sruetzler/HB-SR-Devices-AddOn/devices/HB-SR-HY/docs/HM-CC-TC_HM-CC-VD_Protokoll.md

# HomeMatic HM-CC-TC ↔ HM-CC-VD – Protokolldokumentation

Stand: 2026-11-01

## 1. Scope

Dieses Dokument beschreibt die direkte Funkkommunikation zwischen:

- **HM-CC-TC** – HomeMatic Funk-Wandthermostat
- **HM-CC-VD** – HomeMatic Funk-Stellantrieb

Betrachtet wird die bereits **dekodierte BidCoS-Telegrammebene**:

```text
COUNTER CTRL TYPE SRC DST PAYLOAD
```

Nicht Bestandteil der eigentlichen Protokollbeschreibung sind:

- physikalische 868-MHz-Funkebene
- Preamble / Sync / Whitening / CRC-Berechnung
- Anlernen / Peering
- Kommunikation mit einer CCU

Praktisch relevante **HY-/CC1101-Implementierungserkenntnisse** werden am Ende
bewusst separat dokumentiert. Sie sind keine Eigenschaften der BidCoS-
Protokollsemantik.

Die Dokumentation basiert auf:

1. eQ-3-Gerätehandbüchern,
2. öffentlich dokumentiertem BidCoS-Reverse-Engineering,
3. FHEM-Implementierung für HM-CC-TC/HM-CC-VD,
4. realen HMLAN/FHEM-Funkmitschnitten,
5. lokalen CCU-`multimac`-Mitschnitten, Oszilloskopmessungen an realen TC/VD-Paaren und gezielten HY-Emulationsversuchen.

Da das proprietäre BidCoS-Protokoll nicht vollständig offiziell veröffentlicht wurde, wird zwischen **belegt**, **sehr wahrscheinlich**, **rekonstruiert** und **offen** unterschieden.

---

# 2. Grundprinzip

Der HM-CC-TC ist der eigentliche Raumregler.

Er:

1. misst die Raumtemperatur,
2. kennt Solltemperatur und Zeitprogramm,
3. berechnet daraus eine gewünschte Ventilöffnung,
4. überträgt diese zyklisch an den HM-CC-VD.

Die Regelung benötigt im normalen Betrieb keine CCU.

eQ-3 beschreibt einen zyklischen Kommunikationsabstand von:

```text
120 ... 184 Sekunden
```

Der HM-CC-VD bestätigt den empfangenen Stellbefehl und meldet dabei seinen aktuellen Zustand zurück.

---

# 3. Allgemeiner dekodierter BidCoS-Frame

Auf der hier betrachteten Ebene besteht ein Telegramm aus:

```text
LEN CNT CTRL TYPE SRC SRC SRC DST DST DST PAYLOAD...
```

Dabei:

| Feld | Größe | Bedeutung |
|---|---:|---|
| LEN | 1 Byte | Länge ab `CNT` bis Ende Payload |
| CNT | 1 Byte | Message Counter / Sequence Number |
| CTRL | 1 Byte | Steuerflags |
| TYPE | 1 Byte | Nachrichtentyp |
| SRC | 3 Byte | 24-Bit-Senderadresse |
| DST | 3 Byte | 24-Bit-Empfängeradresse |
| PAYLOAD | variabel | typabhängige Nutzdaten |

Die 24-Bit-Adressen sind Geräteadressen.

---

# 4. Message Counter

Der Message Counter ist 8 Bit breit:

```text
00 ... FF
```

und läuft modulo 256:

```text
FC
FD
FE
FF
00
01
...
```

Er wird bei einer neuen Kommunikationssequenz erhöht.

Eine Anfrage und die zugehörige Antwort verwenden **denselben Counter**.

Beispiel:

```text
TC → VD
CNT=4A A2 58 ...

VD → TC
CNT=4A 82 02 ...
```

Der nächste reguläre Zyklus verwendet anschließend beispielsweise:

```text
CNT=4B
```

---

# 5. Control-Byte

Für die hier relevanten Telegramme sind besonders folgende Bits wichtig:

| Bit | Maske | Bedeutung |
|---:|---:|---|
| 0 | `0x01` | WakeUp |
| 1 | `0x02` | WakeMeUp |
| 2 | `0x04` | Broadcast |
| 4 | `0x10` | Burst |
| 5 | `0x20` | ACK Request |
| 6 | `0x40` | Repeated |
| 7 | `0x80` | Repeat Enable |

## 5.1 `CTRL = 0xA2`

Normale TC→VD-Stelltelegramme verwenden typischerweise:

```text
A2 = 1010 0010
```

gesetzt sind:

```text
0x80 Repeat Enable
0x20 ACK Request
0x02 WakeMeUp
```

Nicht gesetzt ist insbesondere:

```text
0x10 Burst
```

Das normale Stelltelegramm wird also **nicht als Burst** gesendet.

### Bedeutung von WakeMeUp

`WakeMeUp` bedeutet nicht:

> Wecke den Empfänger auf.

Sondern sinngemäß:

> Der Sender ist nach diesem Telegramm noch für kurze Zeit empfangsbereit.

Beim `A2 58` bezieht sich das daher auf den HM-CC-TC als Sender.

Der HM-CC-VD muss bereits aufgrund seines zyklischen Empfangstimings wach sein.

## 5.2 `CTRL = 0x82`

Reale HM-CC-VD-Antworten werden häufig beobachtet als:

```text
82 02
```

`0x82` enthält:

```text
Repeat Enable
WakeMeUp
```

FHEM kann bei einer virtuellen Aktorantwort auch `0x80 02` erzeugen. Für die originale VD-Kommunikation ist `0x82` der typische beobachtete Wert.

---

# 6. TC → VD: CLIMATE_EVENT `TYPE=0x58`

Das zentrale Stelltelegramm lautet:

```text
CNT A2 58 TC_ID VD_ID COMMAND TARGET
```

Mit Length-Byte:

```text
0B CNT A2 58 TC_ID VD_ID COMMAND TARGET
```

## 6.1 Felder

| Feld | Bedeutung |
|---|---|
| CNT | globaler Message Counter des TC |
| CTRL | normalerweise `A2` |
| TYPE | `58` = `CLIMATE_EVENT` |
| SRC | Adresse des HM-CC-TC |
| DST | Adresse des HM-CC-VD |
| Payload 0 | `ADJUSTING_COMMAND` |
| Payload 1 | `ADJUSTING_DATA` / Ventil-Sollwert |

FHEM kommentiert:

```text
adjust_command [0..4]
adj_data       [0..250]
```

## 6.2 Ventil-Sollwert

Der normale Ventil-Sollwert ist ungefähr:

```text
Sollposition [%] = TARGET_RAW / 2.56
```

bzw.

```text
TARGET_RAW ≈ Sollposition [%] × 2.56
```

Beispiele:

| Sollöffnung | Raw ungefähr |
|---:|---:|
| 0 % | `00` |
| 25 % | `40` |
| 50 % | `80` |
| 75 % | `C0` |

FHEM dekodiert den Wert mit:

```text
int(raw / 2.56 + 0.5)
```

Die Sonderfälle Voll-Auf/Voll-Zu können zusätzlich über `ADJUSTING_COMMAND` repräsentiert werden und sollten deshalb nicht ausschließlich aus dem Raw-Wert abgeleitet werden.

---

# 7. `ADJUSTING_COMMAND`

Der Wertebereich ist:

```text
00 ... 04
```

Die vollständige Enum-Bedeutung ist von eQ-3 öffentlich nicht sauber dokumentiert.

Der aktuelle Rekonstruktionsstand ist:

| Wert | vermutete Bedeutung | Sicherheit |
|---:|---|---|
| `00` | normaler zyklischer Stellwert / Refresh | sehr hoch |
| `01` | vermutlich `VENT_OPEN` | offen / Hypothese |
| `02` | `VENT_CLOSED` / OFF | hoch |
| `03` | neuer/geänderter Stellwert | sehr hoch |
| `04` | Entkalkungs-/Ventilfahrt | mittel bis hoch |

## 7.1 `00` – normaler zyklischer Stellwert

Bei unverändertem Sollwert werden reale Telegramme der Form:

```text
A2 58 ... 00 XX
```

beobachtet.

FHEMs TC-Emulation verwendet `00` für die folgenden zyklischen Wiederholungen eines bereits gesetzten Ventilwerts.

Interpretation:

```text
COMMAND = 00
DATA    = aktueller Ventilsollwert
```

## 7.2 `03` – neuer Stellwert

FHEM setzt bei einer Änderung der Ventilposition zunächst:

```text
COMMAND = 03
```

und danach wieder:

```text
COMMAND = 00
```

Ein typischer Ablauf ist daher:

```text
03 <neuer Sollwert>
00 <gleicher Sollwert>
00 <gleicher Sollwert>
00 <gleicher Sollwert>
```

Reale Funkmitschnitte passen zu diesem Verhalten.

## 7.3 `02` – VENT_CLOSED / OFF

Bei `desired-temp = off` wurden reale Telegramme beobachtet wie:

```text
A2 58 ... 02 00
```

Der VD schließt daraufhin das Ventil.

Daher ist sehr wahrscheinlich:

```text
COMMAND = 02
DATA    = 00
```

für den expliziten Sonderzustand `VENT_CLOSED`.

Dies ist semantisch von einem normalen:

```text
00 00
```

zu unterscheiden, auch wenn das mechanische Ergebnis ebenfalls ein geschlossenes Ventil sein kann.

## 7.4 `01` – vermutlich VENT_OPEN

Es gibt einen naheliegenden Zusammenhang mit dem HomeMatic-Sonderzustand `VENT_OPEN`.

Die Zuordnung:

```text
01 = VENT_OPEN
```

ist jedoch noch nicht durch einen ausreichend eindeutigen realen Mitschnitt bestätigt.

**Status: offen.**

## 7.5 `04` – Entkalkungsfahrt

`04` wurde im Zusammenhang mit der regelmäßigen Ventil-/Entkalkungsfahrt beobachtet.

Noch offen sind:

- genaue Bedeutung von `ADJUSTING_DATA`,
- vollständige Telegrammsequenz,
- Verhalten während der Adaptions-/Entkalkungsfahrt.

---

# 8. VD → TC: RESPONSE_ACK_STATUS

Der HM-CC-VD antwortet auf das `0x58` unmittelbar mit einem Response-Telegramm.

Typischer Aufbau:

```text
CNT 82 02 VD_ID TC_ID 01 01 POSITION STATUS RSSI
```

Mit Length:

```text
0E CNT 82 02 VD_ID TC_ID 01 01 POSITION STATUS RSSI
```

Dabei:

```text
TYPE    = 02 = RESPONSE
SUBTYPE = 01 = RESPONSE_ACK_STATUS
```

## 8.1 Felder

| Payload | Bedeutung |
|---:|---|
| Byte 0 | `01` = ACK_STATUS |
| Byte 1 | Kanal, normalerweise `01` |
| Byte 2 | aktuelle Ventilposition |
| Byte 3 | Status / Motor / Fehler |
| Byte 4 | RSSI-/Linkwert |

Der Antwort-Counter ist identisch mit dem Counter des auslösenden `0x58`.

## 8.2 Der TC verwendet `POSITION` für seine Ventilstellungsanzeige

Dies konnte mit einem realen HM-CC-TC und einer gezielt emulierten VD-Antwort direkt validiert werden.

Bei korrekt getroffenem ACK-Timing zeigte der TC exakt den aus `POSITION_RAW` dekodierten Wert:

```text
POSITION_RAW = 0x96 = 150  -> 75 %   -> TC zeigt 75 %
POSITION_RAW = 0x00        ->  0 %   -> TC zeigt  0 %
POSITION_RAW = 0x1E = 30   -> 15 %   -> TC zeigt 15 %
```

Damit ist nicht nur die Skalierung `/2` belegt, sondern auch die Semantik gegenüber dem TC:

```text
ACK_STATUS.POSITION = vom TC angezeigte aktuelle Ventilposition (VST)
```

Der Sollwert im vorherigen `0x58` und der vom VD gemeldete Istwert sind unabhängig. Während einer Motorfahrt kann der TC daher beispielsweise einen neuen Sollwert nahe 100 % senden und im ACK gleichzeitig noch eine deutlich kleinere aktuelle Ventilposition erhalten.

---

# 9. Aktuelle Ventilposition des VD

Die VD-Rückmeldung verwendet **eine andere Skalierung als der TC-Sollwert**.

Es gilt:

```text
Istposition [%] = POSITION_RAW / 2
```

bzw.

```text
POSITION_RAW = Istposition [%] × 2
```

Beispiele:

| Istposition | Raw |
|---:|---:|
| 0 % | `00` |
| 10 % | `14` |
| 25 % | `32` |
| 37 % | `4A` |
| 50 % | `64` |
| 100 % | `C8` |

Damit gilt ausdrücklich:

```text
TC → VD Sollwert: raw / 2.56

VD → TC Istwert: raw / 2
```

Diese unterschiedlichen Skalierungen sind durch FHEM und reale Mitschnitte gut belegt.

---

# 10. VD-Statusbyte

Das Statusbyte wird bisher wie folgt verstanden:

```text
Bit:  7 6 5 4 3 2 1 0
      │ │ └─┬─┘ └─┬─┘ │
      │ │   │     │   └─ unbekannt
      │ │   │     └──── Fehlercode
      │ │   └────────── Motorzustand
      │ └────────────── unbekannt
      └──────────────── Low Battery
```

## 10.1 Motorzustand – Bits 5..4

Maske:

```text
STATUS & 0x30
```

Bekannt:

| Wert | Zustand |
|---:|---|
| `0x00` | Motor steht |
| `0x10` | Motor öffnet |
| `0x20` | Motor schließt |
| `0x30` | Bedeutung noch offen |

FHEM verwendet:

```text
0x00 → stop
0x10 → opening
0x20 → closing
```

## 10.2 Fehler – Bits 3..1

Dekodierung:

```text
error = (STATUS >> 1) & 0x07
```

Bekannte Codes:

| Code | Bedeutung |
|---:|---|
| 0 | kein Fehler |
| 1 | Ventil blockiert / schwergängig |
| 2 | Antrieb locker / nicht korrekt montiert bzw. Stellproblem |
| 3 | Stellbereich zu klein |
| 4 | Batterie kritisch |

Die Anzeigen des originalen VD entsprechen den bekannten Fehlern F1...F4.

## 10.3 Batterie

Zusätzlich wird:

```text
STATUS & 0x80
```

als `Low Battery` ausgewertet.

Damit gibt es mindestens eine Unterscheidung zwischen:

- Batterie niedrig (`Bit 7`)
- Batterie kritisch (`Errorcode 4`)

## 10.4 Noch unbekannte Statusbits

Offen:

```text
Bit 6
Bit 0
Motorcode 0x30
```

---

# 11. ACK-Timing

Das Antworttiming des HM-CC-VD ist für die Kommunikation mit einem realen HM-CC-TC kritisch.

Frühere Abschätzungen nur aus Gateway-/Seriell-Zeitstempeln waren irreführend. Direkte Messungen an `GDO0` eines real funktionierenden TC/VD-Paares zeigen zwischen:

```text
Ende TC A2 58
    ↓
ca. 90...95 ms
    ↓
Beginn VD 82 02
```

Die Größenordnung wurde zusätzlich durch eine VD-Emulation bestätigt:

- eine zu frühe synthetische Antwort wurde vom realen TC nicht dauerhaft als gültige VD-Kommunikation akzeptiert,
- mit einer expliziten Verzögerung von ungefähr `95 ms` vor dem `ACK_STATUS` verschwand der Kommunikationsfehler,
- der TC übernahm anschließend die im `ACK_STATUS` gemeldete Ventilposition korrekt.

Wichtig ist die Bezugsgröße:

```text
~90...95 ms = Ende des empfangenen TC-Funkpakets
              bis Beginn des VD-Antwortpakets
```

Zeitdifferenzen von ungefähr `130 ms` zwischen zwei Gateway-RX-Zeitstempeln enthalten dagegen zusätzlich die Sendedauer des ersten Telegramms und dürfen nicht als reine Antwortlatenz interpretiert werden.

Die **exakte Breite** des vom TC akzeptierten Antwortfensters ist weiterhin nicht bestimmt. Belegt ist aber, dass das Timing nicht beliebig ist und eine deutlich zu frühe Antwort problematisch sein kann.

Ein in FHEM verwendeter 10-Sekunden-Timer ist lediglich ein großzügiger Software-Watchdog zur Erkennung einer ausgebliebenen Statusmeldung und **nicht** die Funk-ACK-Latenz.

---

# 12. Zyklisches Empfangs- und Sendetiming

Der originale HM-CC-VD ist batteriebetrieben und empfängt nicht dauerhaft.

TC und VD verwenden einen deterministischen pseudozufälligen Zeitplan.

eQ-3 dokumentiert einen Zyklus von:

```text
120 ... 184 s
```

Die reverse-engineerte und von FHEM verwendete Formel lautet:

```c
result =
    (((address << 8) | messageCounter)
     * 1103515245 + 12345) >> 16;

interval =
    (result & 0xff) / 4.0 + 120.0;
```

Damit:

```text
Minimum: 120.00 s
Maximum: 183.75 s
Raster:    0.25 s
```

Die ganzzahlige Form in Viertelsekunden ist:

```text
(result & 0xff) + 480
```

---

# 13. Welche Adresse geht in die Timingformel ein?

Verwendet wird die Adresse des **HM-CC-TC**, also des Senders der Stelltelegramme.

Formal:

```text
T = f(TC_ADDRESS, MESSAGE_COUNTER)
```

Interessante mathematische Eigenschaft:

Von der 24-Bit-TC-Adresse wirken für das letztlich verwendete Ergebnis effektiv nur die **unteren 16 Bit**.

Bei:

```text
Adresse = AA BB CC
```

beeinflussen effektiv:

```text
BB CC
```

das Intervall.

FHEMs optimierte Implementierung bildet entsprechend nur diese beiden Bytes in seinen vorberechneten Timingwerten ab.

## 13.1 Folgerung für HY Link B

Auf Link B tritt HY gegenüber dem realen HM-CC-VD als eigener TC-Sender auf.
Für die Timingformel ist deshalb **die logische HY-Adresse** maßgeblich, nicht
die Adresse des ursprünglichen HM-CC-TC auf Link A.

Für HY Nummer `n` gilt entsprechend sinngemäß:

```text
T = f(HY_ADDRESS[n], LINK_B_COUNTER[n])
```

Beispiel für HY6:

```text
Sender auf Link B = FE0106
Timingadresse      = FE0106
```

Die Adresse `1A3F0D` des ursprünglichen TC6 ist für den Link-B-Zeitplan des
mit `FE0106` gepaarten VD6 nicht mehr die Senderadresse.

---

# 14. Welcher Counter bestimmt das nächste Intervall?

Der Counter des **gerade gesendeten TC-Telegramms** bestimmt das Intervall bis zum nächsten globalen TC-Slot.

Beispiel:

```text
CNT=4A  A2 58
   ↓
   T(TC-ID, 4A)
   ↓
CNT=4B  A2 58
   ↓
   T(TC-ID, 4B)
   ↓
CNT=4C  A2 58
```

Damit ist die Reihenfolge ausdrücklich:

```text
Frame mit Counter n senden
        ↓
Intervall f(TC-ID, n) abwarten
        ↓
optional implementationsspezifischer Offset
        ↓
Frame mit Counter n+1 senden
```

Nicht korrekt wäre, bereits für den Abstand `n → n+1` die Formel mit `n+1` auszuwerten.

## 14.1 Lokale Validierung am TC `20209C`

Ein lokaler `multimac`-Mitschnitt lieferte zwei aufeinanderfolgende Zyklen:

```text
16:19:01  CNT=CE  20209C -> FE0102  A2 58 ... 03 FA
16:22:04  CNT=CF  20209C -> FE0102  A2 58 ... 03 FA
```

Beobachteter Abstand:

```text
ca. 183 s
```

Die Timingformel ergibt für:

```text
TC-ID = 20209C
CNT   = CE
```

ungefähr:

```text
183.25 s
```

Damit bestätigt dieser reale Mitschnitt sehr gut, dass **der aktuelle Counter `CE`** den Abstand zum folgenden Counter `CF` bestimmt.

Auch ein längerer Mitschnitt mit empfangenen Countern `81` und später `86` war zeitlich mit den dazwischenliegenden berechneten Slots konsistent, obwohl die Zwischenframes am untersuchten Empfänger nicht empfangen wurden.

## 14.2 Lokale HY-Zeitbasis der finalen HY-Hardware

Die frühere Pro-Mini-Testhardware zeigte eine deutliche lokale
Zeitbasisabweichung und benötigte zeitweise den experimentellen Faktor:

```text
9966 / 10000
```

Dieser Befund gilt **nicht** für die finale HY-Hardware mit ATmega328P und
externem 8-MHz-Quarz.

Die finale Hardware wurde über identische eingehende TC-Telegramme gleichzeitig
gegen:

- die lokale HY-Zeitmessung (`micros()`),
- unabhängige CCU-`multimac`-Zeitstempel

verglichen.

Über den längeren Vergleichslauf ergab sich zwischen HY und CCU nur eine
Größenordnung von ungefähr:

```text
ca. 2...3 ppm
```

Beispiel TC6:

```text
CCU: 129.004 s
HY:  129.004160 s
```

Die Differenz beträgt damit nur ungefähr `0,16 ms` auf `129 s`.

Folgerung:

> Für die finale HY-Hardware ist keine Korrektur in der Größenordnung
> `9966/10000` erforderlich.

Die frühere `9966/10000`-Korrektur war eine Eigenschaft der damaligen
Testhardware bzw. deren Zeitbasis und keine BidCoS-Konstante.

## 14.3 Reale Original-TCs laufen geringfügig länger als die Idealformel

Ein längerer Mitschnitt mehrerer originaler HM-CC-TC zeigte, dass die realen
Abstände zwischen zwei aufeinanderfolgenden `0x58`-Telegrammen zwar sehr dicht
an der rekonstruierten Timingformel liegen, aber systematisch geringfügig
länger sein können.

Ohne einzelne ungefähr `+100 ms` große Sonderausreißer lagen die typischen
Abweichungen der untersuchten TCs ungefähr im Bereich:

```text
+13 ... +32 ppm
```

entsprechend grob:

```text
+2 ... +5 ms
```

bei typischen Intervallen von etwa 120...180 s.

Für TC6 (`1A3F0D`) wurden beispielsweise wiederholt ungefähr `+30...32 ppm`
beobachtet.

Diese kleinen Unterschiede sind sehr wahrscheinlich reale Geräte-/Takt-
toleranzen und **keine individuelle Protokollkonstante pro TC**. Ein originaler
HM-CC-VD muss mit unterschiedlichen originalen TCs funktionieren und folglich
eine entsprechende Toleranz besitzen.

Zusätzlich wurden bei mehreren TCs einzelne Intervalle mit ungefähr `+100 ms`
beobachtet. HY und CCU sahen dabei dieselbe Verzögerung; sie stammt daher nicht
aus der HY-Zeitmessung. Die genaue Ursache dieser seltenen Sonderverzögerungen
ist noch offen.

---

# 15. FHEM-Timingoffset

FHEMs virtuelle TC-Implementierung besitzt zusätzlich:

```text
cyclicMsgOffset
```

mit einem Default von ungefähr:

```text
+200 ms
```

zum berechneten Zeitpunkt.

Dieser Wert ist ein praktischer Implementierungswert von FHEM und keine
nachgewiesene Protokollkonstante.

## 15.1 Aktuelle praktische Validierung mit originalen VDs

Ein zusätzlicher **fester** Offset von `+200 ms` ist im aktuellen HY-Aufbau
nicht erforderlich.

Die entscheidende neue Beobachtung ist stattdessen eine sehr kleine
**proportionale Verlängerung der zyklischen Link-B-Intervalle**.

Zunächst wurde HY6/VD6 mit der idealen Formel ohne Skalierung betrieben.
In einem längeren Lauf wurden nur ungefähr:

```text
68 / 123 = 55,3 %
```

der tatsächlich gesendeten Link-B-Telegramme vom VD6 bestätigt.

Ein konstanter Phasenversuch mit:

```text
+100 ms
```

brachte keine Verbesserung.

Anschließend wurde ausschließlich die Intervalllänge mit:

```text
T_HY = T_Formel × 1.000030
```

also:

```text
+30 ppm
```

verlängert.

Nach Resynchronisation des VD6 ergab ein mehrstündiger Lauf:

```text
144 ACKs / 147 gesendete Telegramme
= 97,96 %
```

Die Verbesserung stammt damit nicht von einem festen Phasenoffset, sondern von
der geringfügig längeren laufenden Zeitbasis des zyklischen Sendeplans.

Danach wurde derselbe Faktor **global für alle logischen HYs** verwendet.
Alle HYs benutzen denselben Faktor; es gibt keine individuelle ppm-Kalibrierung
pro HY.

Für zehn nach dem Firmwarestart synchronisierte VDs ergab der erste
Vergleichslauf:

```text
223 ACKs / 224 gesendete Telegramme
= 99,55 %
```

Der einzige Miss lag zeitlich in einem konkurrierenden Funktelegramm und ist
mit einer normalen Funkkollision vereinbar.

Damit gilt für den aktuell getesteten Aufbau:

```text
fester Link-B-Offset:       0 ms
globaler Link-B-Zeitfaktor: +30 ppm
```

Wichtig:

> `+30 ppm` ist derzeit ein empirisch validierter HY-Implementierungswert.
> Er ist **keine veröffentlichte HomeMatic-/BidCoS-Protokollkonstante**.

Er liegt jedoch in derselben Größenordnung wie die an mehreren originalen TCs
gemessene geringe Verlängerung gegenüber der idealen Timingformel.

---

# 16. Exakte Breite des VD-Empfangsfensters

Die exakte Lage und Dauer des normalen stromsparenden RX-Fensters sind derzeit **nicht belastbar bekannt**.

Bekannt ist:

```text
Zeitpunkt des Zyklus = berechenbar
```

und für den aktuell getesteten HY-Aufbau praktisch bestätigt ist:

```text
berechneter Slot
+
globale geringe Intervallskalierung (+30 ppm)
+
kein zusätzlicher fester Offset
```

trifft das Empfangsfenster der getesteten originalen VDs sehr zuverlässig.

Unbekannt bleibt weiterhin:

```text
RX start = T - ?
RX end   = T + ?
```

Die genaue Fensterbreite ist für die aktuelle HY-Implementierung nicht mehr
erforderlich, bleibt protokolltechnisch aber bewusst offen.

---

# 17. Verlust einzelner Telegramme

Die Synchronisation ist so ausgelegt, dass nicht jedes Stelltelegramm zwingend empfangen werden muss.

FHEM kann bei seiner virtuellen TC-Implementierung gezielt zyklische Nachrichten auslassen (`msgReduce`).

Die FHEM-Dokumentation warnt:

```text
VD will lose connection with more then 5 skips
```

Dies ist ein starker Hinweis darauf, dass ein VD einige verpasste Zyklen toleriert.

Ein plausibles internes Modell ist:

```text
letzten Counter kennen
      ↓
nächste Counter selbst hochzählen
      ↓
für jeden Counter nächsten Slot berechnen
      ↓
nur bei zu vielen Ausfällen Sync verlieren
```

Die exakte originale interne Grenze sollte trotzdem als Implementierungsdetail betrachtet werden; FHEMs `>5` ist kein veröffentlichter Firmwarecode von eQ-3.

---

# 18. Verhalten bei fehlendem ACK

Für FHEMs TC-Emulation gilt:

1. ein `A2 58` wird gesendet,
2. FHEM wartet auf eine neue VD-Positionsmeldung,
3. nach 10 s wird ein `miss` gezählt,
4. nach mehr als fünf fehlenden Antworten wird der Zustand `lost`,
5. der normale zyklische Zeitplan läuft weiter.

In der FHEM-TC-Emulation ist kein sofortiges erneutes `A2 58` als Funk-Retry vorgesehen.

## 18.1 Beobachtung am originalen HM-CC-TC

In einem lokalen Test wurde ein `A2 58` des originalen TC von einer passiv mithörenden CCU sicher empfangen, während der adressierte HY-Empfänger dieses Telegramm verpasste und deshalb **kein ACK** senden konnte:

```text
16:19:01  CNT=CE  TC 20209C -> FE0102  A2 58 ... 03 FA
           kein ACK vom adressierten Empfänger
```

Die CCU beobachtete anschließend **keinen unmittelbaren Retry** mit demselben Counter.

Das nächste `A2 58` kam erst im regulären nächsten Slot:

```text
16:22:04  CNT=CF  TC 20209C -> FE0102  A2 58 ... 03 FA
```

Der Abstand von ungefähr `183 s` entspricht dem für `CNT=CE` berechneten normalen Zyklus (`183.25 s`).

Damit ist für den beobachteten Original-TC sehr gut belegt:

```text
fehlendes ACK
    ↓
kein sofortiger A2-58-Retry
    ↓
Counter läuft im regulären Zyklus weiter
```

Ob es in anderen Sonderzuständen oder nach mehreren aufeinanderfolgenden Misses zusätzliche Retry-/Recovery-Mechanismen gibt, bleibt offen.

Wichtig:

`Repeat Enable` (`CTRL Bit 7`) bedeutet nicht automatisch einen Retry durch den TC selbst. Es erlaubt insbesondere die Wiederholung durch einen BidCoS-Repeater.

---

# 19. Mehrere HM-CC-VD an einem TC

Reale Funkmitschnitte bestätigen, dass ein HM-CC-TC mehrere HM-CC-VD über einen **gemeinsamen globalen Message Counter** und einen **gemeinsamen globalen Timingzyklus** bedient.

Für zwei VDs wurde beispielsweise beim TC `172987` beobachtet:

```text
CNT=C8 → VD 10FC23
CNT=C9 → VD 13A146
CNT=CA → VD 10FC23
CNT=CB → VD 13A146
...
```

Für drei VDs wurde beim TC `187A60` beobachtet:

```text
CNT=D8 → VD 1379E3
CNT=D9 → VD 20368F
CNT=DA → VD 193A01
CNT=DB → VD 1379E3
CNT=DC → VD 20368F
CNT=DD → VD 193A01
...
```

Damit ist empirisch belegt:

- ein **gemeinsamer globaler TC-Counter** für alle zugeordneten VDs,
- ein **gemeinsamer globaler Timingzyklus**,
- pro globalem Slot wird genau ein VD adressiert,
- der Counter wird beim Wechsel des Ziel-VD normal weitergezählt,
- zwei und drei VDs werden zyklisch im Round-Robin bedient.

Nicht beobachtet wurde, dass mehrere VDs innerhalb desselben globalen Slots denselben Counter erhalten.

## 19.1 Round-Robin

Für zwei und drei VDs ist der zyklische Ablauf damit direkt durch reale Mitschnitte bestätigt:

```text
2 VDs:
VD1 → VD2 → VD1 → VD2 → ...

3 VDs:
VD1 → VD2 → VD3 → VD1 → VD2 → VD3 → ...
```

Für vier VDs ist ein entsprechender Ablauf:

```text
VD1 → VD2 → VD3 → VD4 → VD1 → ...
```

weiterhin eine sehr plausible Extrapolation, wurde aber bislang nicht mit einem vollständigen Vier-VD-Mitschnitt direkt bestätigt.

## 19.2 Timing bleibt global

Das nächste Intervall hängt weiterhin nur von:

```text
TC-Adresse
+
globalem Counter
```

ab.

Nicht von der Adresse des aktuell ausgewählten VD.

---

# 20. Synchronisation bei mehreren VDs

Hier ergibt sich trotz des inzwischen bestätigten Round-Robin weiterhin eine wichtige Rekonstruktion.

Bei drei real beobachteten VDs wird ein einzelner VD nur in jedem dritten globalen Slot direkt adressiert. Der Abstand zwischen zwei an denselben VD adressierten Stelltelegrammen kann damit deutlich größer als 184 s werden.

Gleichzeitig benötigt der VD laut Hersteller bei vollständigem Synchronisationsverlust maximal 184 s Dauerempfang, um wieder zu synchronisieren.

Das spricht stark dafür, dass ein VD auch Telegramme seines bekannten TC beobachten kann, die an **andere VDs** adressiert sind, um:

```text
TC-Counter
+
globalen Zyklus
```

mitzuverfolgen.

Beispiel:

```text
TC → VD1  CNT=80

TC → VD2  CNT=81
VD1 kann globalen TC-Zustand mithören

TC → VD3  CNT=82

TC → VD1  CNT=83
```

**Status:** starke Rekonstruktion, aber nicht durch veröffentlichten originalen Firmwarecode bestätigt.

---

# 21. `TYPE=0x70` WEATHER_EVENT

In realen HM-CC-TC-Mitschnitten erscheint zusätzlich:

```text
CTRL=86
TYPE=70
DST=000000
```

also ein Weather-/Broadcast-Telegramm.

Die zeitliche Kopplung zum Stelltelegramm ist inzwischen auch lokal mehrfach bestätigt:

```text
t = -20 s
CNT=n  86 70 ...

t = 0
CNT=n  A2 58 ...
```

`0x70` und das nachfolgende `0x58` benutzen dabei **denselben Counter**.

## 21.1 Lokaler Original-TC-Mitschnitt

Für den TC `20209C` wurden beispielsweise beobachtet:

```text
16:18:41  CNT=CE  86 70  20209C -> 000000
16:19:01  CNT=CE  A2 58  20209C -> FE0102   03 FA

16:21:44  CNT=CF  86 70  20209C -> 000000
16:22:04  CNT=CF  A2 58  20209C -> FE0102   03 FA
```

Damit ist für diese Zyklen exakt die Struktur sichtbar:

```text
WEATHER_EVENT(counter=n)
        ↓ 20 s
CLIMATE_EVENT(counter=n)
        ↓ T(TC-ID,n)
WEATHER_EVENT(counter=n+1)
        ↓ 20 s
CLIMATE_EVENT(counter=n+1)
```

Die `0x70`-Nachricht enthält unter anderem Temperatur-/Feuchteinformationen des TC.

Für die reine VD-Stellkommunikation ist weiterhin nicht belegt, dass der VD dieses Telegramm zwingend benötigt. FHEMs virtuelle TC-Steuerung eines HM-CC-VD funktioniert grundsätzlich über die `0x58`-Kommunikation.

Daher:

**`0x70` ist eindeutig Bestandteil des zyklischen TC-Funkverhaltens und zeitlich/counterseitig fest mit dem folgenden `0x58` gekoppelt; seine direkte funktionale Relevanz für den VD bleibt offen.**

---

# 22. Resynchronisation des originalen HM-CC-VD

eQ-3 dokumentiert ausdrücklich:

Der VD ist zur Batterieschonung nicht dauerhaft auf Empfang.

Wenn die Funkverbindung längere Zeit gestört ist, versucht der VD:

```text
einmal pro Stunde
```

eine Neusynchronisation.

Dazu geht er:

```text
maximal 184 Sekunden
```

auf Dauerempfang.

Während des Kommunikationsfehlers fährt er die gespeicherte Störungsposition an.

Werkseinstellung laut Handbuch:

```text
15 %
```

Nach Batteriewechsel wird ebenfalls neu synchronisiert.

Die Synchronisation erfolgt:

- automatisch innerhalb einer Stunde,
- alternativ durch kurzen Tastendruck am VD sofort angestoßen.

Der kurze Tastendruck wurde in den lokalen HY-Tests praktisch bestätigt:
Nach verlorenem Link-B-Timing und mehreren unbeantworteten Zyklen antwortete
der originale VD nach dem ausgelösten Resync wieder auf einen passenden
folgenden Zyklus.

In einem späteren kontrollierten HY-Neustarttest wurden fünf VDs absichtlich
**nicht** manuell resynchronisiert. Direkt nach dem Neustart bestätigten sie
zunächst kein einziges Link-B-Telegramm. Alle fünf fanden die neue Link-B-Phase
anschließend selbständig wieder.

Der erste erfolgreiche ACK trat ungefähr:

```text
71 ... 75,5 Minuten
```

nach dem HY-Start auf. Danach liefen die betroffenen Links wieder überwiegend
stabil weiter.

Damit ist die automatische Resynchronisation nach einem Neustart des
TC-Nachbaus nicht mehr nur aus dem Handbuch abgeleitet, sondern im HY-Aufbau
auch praktisch beobachtet.

Die genaue interne Resync-Logik des VD ist weiterhin nicht vollständig
rekonstruiert.

---

# 23. Warum 184 Sekunden Resync plausibel sind

Das maximale reguläre TC-Intervall beträgt:

```text
183.75 s
```

Der VD hört bei Resync maximal:

```text
184 s
```

Damit umfasst das Dauerempfangsfenster mindestens einen vollständigen maximalen TC-Zyklus.

Dies ist eine sehr plausible Erklärung für die Wahl der 184 s.

Die Schlussfolgerung ist logisch aus den beiden Zeitwerten abgeleitet; eQ-3 erklärt diesen Zusammenhang im Handbuch nicht ausdrücklich.

---

# 24. Neustart / Batteriewechsel des VD

Nach einem normalen Batteriewechsel:

- die Peer-/Partnerbeziehung muss nicht neu angelernt werden,
- die Funk-Synchronisation muss neu aufgebaut werden.

Daraus folgt:

```text
VD Neustart
   ↓
Peer-Daten weiterhin vorhanden
   ↓
zyklischer Timingzustand nicht sicher vorhanden
   ↓
Resync
   ↓
normaler Betrieb
```

Für die Synchronisation benötigt der VD prinzipiell wieder:

```text
TC-Adresse
aktuellen Counter
aktuellen Empfangszeitpunkt
```

Ein gültiges Telegramm des bekannten TC reicht daher als plausible Grundlage, um den zukünftigen Zeitplan erneut zu bestimmen.

## 24.1 Praktische Resynchronisation nach HY-Neustart

Ein HY-Neustart startet Link B mit einer neuen lokalen Zeitphase. Der reale VD
kann deshalb unmittelbar danach zunächst außerhalb seines normalen
Empfangsfensters liegen.

Zwei Recovery-Wege wurden praktisch beobachtet.

### Manueller Sofort-Resync

Nach mehreren unbeantworteten Link-B-Zyklen konnte ein kurzer Tastendruck am
VD die Resynchronisation sofort anstoßen. Der VD antwortete anschließend wieder
auf einen passenden folgenden Zyklus.

### Automatischer Resync ohne Eingriff

In einem späteren Test wurden nach einem HY-Firmwarestart gezielt folgende fünf
VDs **nicht** manuell synchronisiert:

```text
HY3
HY4
HY6
HY9
HY11
```

Direkt nach dem Neustart ergab sich für diese Gruppe zunächst:

```text
0 ACKs / 122 gesendete Telegramme
```

Die übrigen zehn VDs waren manuell synchronisiert und bestätigten im selben
Zeitraum:

```text
223 / 224
```

gesendete Telegramme.

Ohne weiteren Eingriff synchronisierten sich anschließend **alle fünf**
unsynchronisierten VDs automatisch. Der erste erfolgreiche ACK lag je nach VD
ungefähr `71...75,5 Minuten` nach dem HY-Start.

Nach dem ersten erfolgreichen ACK liefen die Links wieder stabil bzw. nahezu
stabil weiter. Beobachtet wurden unmittelbar danach beispielsweise:

```text
HY9:  8/8
HY3:  6/7
HY4:  7/7
HY6:  6/6
HY11: 6/6
```

Damit ist für den aktuellen Aufbau praktisch bestätigt:

```text
HY-Neustart
   ↓
Link-B-Phase zunächst verloren
   ↓
VD antwortet zunächst nicht
   ↓
normaler automatischer VD-Resync
   ↓
neue HY-Phase wird gefunden
   ↓
normaler zyklischer Betrieb
```

Für HY ist daher **keine zusätzliche Persistenz der exakten Link-B-Phase über
einen normalen Neustart erforderlich**, solange die vom originalen VD
vorgesehene automatische Resynchronisation akzeptiert wird.

Eine Soft-Watchdog-Recovery darf vorhandenen Zustand weiterhin erhalten, um
eine unnötige Resync-Phase zu vermeiden; sie ist aber nicht Voraussetzung für
die grundsätzliche Wiederherstellung nach einem echten Neustart.

---

# 25. Neustart des TC

Beim Batteriewechsel des HM-CC-TC bleiben die angelernten Geräte grundsätzlich erhalten; Datum/Uhrzeit müssen nach dem Batteriewechsel wieder gesetzt bzw. synchronisiert werden.

Nicht belastbar geklärt ist:

```text
Bleibt der Message Counter über einen TC-Power-Cycle erhalten?
```

Möglichkeiten:

1. Counter persistent,
2. Counter startet neu,
3. anderer Initialwert.

**Status: offen.**

Falls der TC nach einem Neustart seinen Counter oder seine zeitliche Phase verliert, kann ein originaler VD zunächst die Synchronisation verlieren und später über seinen stündlichen 184-s-Resync wieder einsteigen.

---

# 26. FHEM-Verhalten bei Neustart eines virtuellen TC

FHEM speichert für seinen virtuellen TC:

```text
Message Counter
+
nächsten Sendetermin
```

in einem Reading `.next`.

Beim Wiederanlauf werden diese Werte wieder geladen.

Dies zeigt, wie ein TC-Nachbau den Zustand über einen Neustart erhalten kann.

Es beweist jedoch **nicht**, dass der originale HM-CC-TC intern genau dasselbe macht.

---

# 27. Reale Beispieltelegramme

## 27.1 Normaler Stellbefehl

```text
TC → VD
30 A2 58 1CE246 1CEB87 00 60
```

Interpretation:

```text
COMMAND = 00
TARGET  = 0x60 = 96
96 / 2.56 = 37.5 %
```

Antwort:

```text
VD → TC
30 82 02 1CEB87 1CE246 01 01 4A 00 36
```

Position:

```text
0x4A = 74
74 / 2 = 37 %
```

Damit stehen Soll und Ist praktisch auf derselben Position.

## 27.2 Motor schließt

Beispiel:

```text
TC → VD
AB A2 58 1BF7FA 1BFC82 03 16
```

Antwort:

```text
VD → TC
AB 82 02 1BFC82 1BF7FA 01 01 14 20 39
```

Position:

```text
0x14 / 2 = 10 %
```

Status:

```text
0x20 → Motor schließt
```

Der VD meldet also sofort seine aktuelle Position und den laufenden Motorzustand.

Er wartet nicht, bis das neue Ziel erreicht ist.

## 27.3 Lokale Validierung mit realem TC und emuliertem VD

Ein realer TC `20209C` sendete:

```text
86 A2 58 20209C FE0102 03 FA
```

Interpretation:

```text
COMMAND = 03
TARGET  = FA = 250
250 / 2.56 = 97.66 %
```

Die emulierte VD-Seite antwortete nach dem gemessenen Antwortdelay mit:

```text
86 82 02 FE0102 20209C 01 01 1E 20 48
```

Interpretation:

```text
POSITION = 1E = 30 / 2 = 15 %
STATUS   = 20 = closing
```

Der reale TC übernahm daraufhin die gemeldeten `15 %` als Ventilstellung. Damit sind Antwortformat, Countergleichheit, `CTRL=82`, Positionsskalierung und die Verwendung der Position durch den TC gemeinsam praktisch validiert.

Dabei ist zu beachten: Das Telegramm stammt in diesem Test von einer Emulation und ist deshalb kein Beleg dafür, dass ein originaler VD das letzte RSSI-Byte exakt auf dieselbe Weise erzeugt.

---

# 28. Wesentliche Zustandsmaschine im Normalbetrieb

Vereinfacht:

```text
HM-CC-TC                           HM-CC-VD
    |                                  |
    |                                  | sleep
    |                                  |
    |     berechneter globaler Slot    |
    |                                  |
    | A2 58                            |
    | Sollposition                     |
    |--------------------------------->|
    |                                  |
    |                            Soll übernehmen
    |                            ggf. Motor starten
    |                                  |
    |        82 02 ACK_STATUS          |
    |        Istposition + Status      |
    |<---------------------------------|
    |                                  |
    |                                  | sleep
    |                                  |
    | T(TC-ID, Counter)                |
    |----------------------------------|
    |                                  |
    | nächster Counter / Slot          |
```

---

# 29. Was als gesichert bzw. ausreichend belegt gilt

## Sehr gut belegt

- TC ist der eigentliche Regler.
- VD erhält zyklisch Ventilbefehle.
- Zyklus liegt bei 120...184 s.
- `TYPE=58` ist das zentrale TC→VD-Climate-Event.
- Payload enthält `ADJUSTING_COMMAND` + Stellwert.
- TC-Sollwert wird ungefähr mit `/2.56` dekodiert.
- VD antwortet mit `TYPE=02`, Subtype `01` ACK_STATUS.
- ACK verwendet denselben Counter.
- VD-Istposition wird mit `/2` dekodiert.
- Statusbits `opening`, `closing`, `stop`.
- Fehlercodes 0...4 wie dokumentiert.
- Timingformel 120.00...183.75 s.
- Timing ist abhängig von TC-Adresse + Message Counter.
- Counter läuft modulo 256.
- VD-Resync: einmal pro Stunde, max. 184 s Dauerempfang.
- FHEM kann als virtueller TC einen echten VD bedienen.
- Originale VD-Antworten verwenden im beobachteten Normalbetrieb `CTRL=0x82`.
- Der reale TC übernimmt `ACK_STATUS.POSITION` als angezeigte Ventilstellung; `POSITION_RAW / 2` wurde mit 0 %, 15 % und 75 % praktisch validiert.
- Das VD-ACK muss in einem definierten Zeitfenster kommen; direkte GDO0-Messungen ergeben ungefähr 90...95 ms vom Ende des TC-Pakets bis zum Beginn der VD-Antwort.
- `TYPE=0x70` wird ungefähr 20 s vor dem zugehörigen `TYPE=0x58` mit demselben Counter gesendet.
- Bei einem beobachteten fehlenden ACK sendete der originale TC keinen unmittelbaren `A2 58`-Retry, sondern setzte den regulären Counter-/Timingzyklus fort.
- Für `TC=20209C`, `CNT=CE` wurden berechnet 183.25 s und real ungefähr 183 s bis `CNT=CF` beobachtet; damit ist die Verwendung des aktuellen Counters für das Folgeintervall praktisch bestätigt.
- Ein zusätzlicher fester `+200-ms`-Link-B-Offset ist im aktuellen HY-Aufbau nicht erforderlich.
- Die finale HY-Hardware mit externem 8-MHz-Quarz weicht gegenüber unabhängigen CCU-Zeitstempeln nur um wenige ppm ab; die frühere `9966/10000`-Korrektur der Pro-Mini-Testhardware ist nicht mehr erforderlich.
- Mehrere originale TCs zeigten gegenüber der idealen Timingformel typische reale Intervallverlängerungen von ungefähr `+13...+32 ppm`.
- Eine globale Link-B-Intervallskalierung von `+30 ppm` verbesserte HY6 von ungefähr `55,3 %` auf `97,96 %` ACK-Erfolg und erreichte in einem anschließenden 10-VD-Test `223/224 = 99,55 %`.
- Nach HY-Neustart synchronisierten sich fünf absichtlich nicht manuell synchronisierte VDs selbständig nach ungefähr `71...75,5 Minuten` wieder auf die neue Link-B-Phase.
- Mit verbreiterter CC1101-RX-Bandbreite (`MDMCFG4=0x88`, ca. 203,1 kHz) wurden mindestens 16 aufeinanderfolgende VD-ACKs direkt vom HY korrekt empfangen.
- Bei mehreren VDs verwendet ein TC einen **globalen Counter** und einen **globalen Timingzyklus**; pro Slot wird genau ein VD bedient.
- Round-Robin wurde mit zwei VDs (`172987`: `10FC23`, `13A146`) und drei VDs (`187A60`: `1379E3`, `20368F`, `193A01`) praktisch bestätigt.
- Ein kurzer Tastendruck am originalen VD konnte in einem lokalen Test eine verlorene Funk-Synchronisation praktisch wieder anstoßen.

## Sehr wahrscheinlich / stark rekonstruiert

- `COMMAND=00` = normaler Refresh.
- `COMMAND=03` = neuer Stellwert.
- `COMMAND=02` = explizites VENT_CLOSED/OFF.
- VDs können wahrscheinlich fremdadressierte `0x58` desselben TC für globale Synchronisation mithören.

---

# 30. Offene Punkte

Folgende Punkte sind noch nicht vollständig geklärt:

## Telegramme

- genaue Semantik `ADJUSTING_COMMAND=01`
- vollständige Semantik `ADJUSTING_COMMAND=04`
- Payload während Entkalkungs-/Adaptionsfahrt
- Bedeutung STATUS Bit 6
- Bedeutung STATUS Bit 0
- Bedeutung Motorcode `0x30`
- genaue Interpretation / physikalische Skalierung des letzten RSSI-Bytes

## Timing

- exakte Lage des normalen VD-RX-Fensters
- exakte Breite des normalen VD-RX-Fensters
- exakte Breite/Toleranz des TC-Antwortfensters um den gemessenen VD-ACK-Zeitpunkt (~90...95 ms nach Ende des TC-Pakets)
- genaue Ursache der kleinen systematischen Abweichung originaler TCs von der Idealformel (`ca. +13...+32 ppm`)
- ob `+30 ppm` der beste allgemeine HY-Nennwert ist oder innerhalb eines kleinen Bereichs weiter optimiert werden sollte; der aktuelle Langzeittest läuft weiter
- Ursache der selten beobachteten ungefähr `+100-ms`-Verzögerungen einzelner originaler TC-Zyklen
- genaue historische Motivation des FHEM-Defaultoffsets von `+200 ms`; für den aktuell getesteten HY-Aufbau ist ein solcher fester Offset nicht erforderlich

## Fehlerfälle

- Recovery-Verhalten des originalen HM-CC-TC nach mehreren aufeinanderfolgenden fehlenden ACKs; ein sofortiger Retry bei einem einzelnen Miss wurde im lokalen Original-TC-Test nicht beobachtet
- Verhalten des TC mit mehreren VDs, wenn ein einzelner VD dauerhaft nicht antwortet
- exakte Anzahl tolerierter Misses im originalen VD

## HY-Hardware / RF

- genaue Ursache der starken Empfindlichkeit des aktuellen Aufbaus gegenüber parasitärer Belastung am 3,3-V-Netz
- ob die verbreiterte RX-Bandbreite auf einer final optimierten HY-Hardware weiterhin notwendig ist

## Neustart

- Message-Counter-Verhalten des originalen HM-CC-TC nach Power-Cycle
- Erhalt oder Neuanfang der exakten zeitlichen Phase nach TC-Neustart

## Mehrere VDs

- Round-Robin für vier VDs noch nicht direkt mit vollständigem Mitschnitt bestätigt

---

# 31. Bewusst nicht betrachtet

Für den aktuellen Anwendungsumfang nicht erforderlich:

- Pairing-/Teach-in-Sequenz
- CCU-Kommunikation
- AES-/Security-Handshakes
- rohe 868-MHz-Modulation
- Preamble
- Sync
- Whitening/Obfuscation
- CRC
- konkrete Funkchip-Konfiguration

---

# 32. HY-/CC1101-Implementierungserkenntnisse

Dieser Abschnitt beschreibt **keine BidCoS-Protokollsemantik**, sondern
praktische RF-/Hardware-Erkenntnisse des aktuell getesteten HY-Aufbaus.

## 32.1 Ausgangslage

AskSin++ initialisierte den verwendeten CC1101 unter anderem mit:

```text
MDMCFG4 = 0xC8
FSCTRL0 = 0x00
```

`MDMCFG4=0xC8` entspricht bei 26 MHz einer RX-Kanalbandbreite von ungefähr:

```text
101,6 kHz
```

Mit dieser Einstellung traten sporadische Link-B-Verluste auf.

Dabei konnten zwei unterschiedliche Fälle beobachtet werden:

```text
a) HY → VD wurde gesendet, aber der VD antwortete nicht
b) VD antwortete nachweislich auf der Luft,
   aber HY dekodierte keinen gültigen ACK_STATUS
```

Fall b wurde durch gleichzeitigen CCU-Mitschnitt eindeutig bestätigt.

## 32.2 GDO0-/FIFO-Hypothese

Zunächst wurde geprüft, ob ein vorhandener VD-ACK nur wegen eines verpassten
CC1101-GDO0-/READ-Ereignisses nicht von AskSin++ verarbeitet wurde.

Nach einem normalen `300 ms` langen Empfangsfenster wurde testweise der
READ-Zustand künstlich angestoßen und erneut aus dem RX-FIFO gelesen.

Beobachtung:

```text
VD-ACK auf der Luft sichtbar
HY normal read: timeout
forced read: empty
```

Damit lag der fehlende ACK nicht lediglich ungelesen im RX-FIFO.

Bei den betroffenen Fällen blieb der CC1101 im RX-Zustand, was dazu passt,
dass kein vollständiger gültiger Frame dekodiert wurde.

## 32.3 Verbreiterte RX-Bandbreite

Als gezielter RF-Test wurde ausschließlich die RX-Bandbreite verändert:

```text
MDMCFG4: 0xC8 → 0x88
FSCTRL0: 0x00 → 0x00
```

Damit wurde die RX-Bandbreite ungefähr geändert von:

```text
101,6 kHz → 203,1 kHz
```

Die Mittenfrequenz blieb unverändert.

Mit dieser Einstellung wurden anschließend mindestens:

```text
16 / 16
```

aufeinanderfolgende Link-B-Zyklen mit vom HY selbst korrekt empfangenem
VD-`ACK_STATUS` beobachtet.

Im gleichen Zeitraum bestätigte der unabhängige CCU-Mitschnitt jeweils die
zugehörigen VD-Antworten.

Für den aktuell getesteten HY-Aufbau gilt deshalb als bewährte
CC1101-Einstellung:

```text
MDMCFG4 = 0x88
FSCTRL0 unverändert
keine feste Frequenzverschiebung
```

Diese Einstellung ist eine HY-/Hardwaremaßnahme und keine Eigenschaft des
HomeMatic-Protokolls.

## 32.4 Frequenzabweichung / FREQEST

Bei Diagnosemessungen des originalen TC `20209C` wurden wiederholt Werte von:

```text
FREQEST = +13 / +14
```

beobachtet.

Bei einem 26-MHz-CC1101 entspricht ein FREQEST-Schritt ungefähr:

```text
1,587 kHz
```

also grob:

```text
+13 ≈ +20,6 kHz
+14 ≈ +22,2 kHz
```

Bei erfolgreich empfangenen VD-Antworten wurden jedoch deutlich andere und
teils stark schwankende FREQEST-Werte beobachtet.

Daraus folgt ausdrücklich **keine** belastbare gemeinsame feste
Frequenzkorrektur für TC und VD.

Der aktuelle erfolgreiche Stand ist deshalb:

```text
FSCTRL0 nicht verschieben
RX-Bandbreite verbreitern
```

Eine experimentelle feste Frequenzverschiebung soll nicht als
Protokolleigenschaft übernommen werden.

## 32.5 Hardwareempfindlichkeit des aktuellen Aufbaus

Während der RF-Diagnose wurde beobachtet, dass bereits eine x10-
Oszilloskop-Tastspitze am 3,3-V-Netz das Funkverhalten deutlich beeinflussen
kann.

Das ist ein starker Hinweis auf eine verbleibende Empfindlichkeit bezüglich:

- Versorgung,
- Layout,
- Masseführung,
- HF-Anpassung / Antennenankopplung,
- parasitärer Kapazitäten.

Die genaue Ursache ist noch offen.

Dieser Befund ändert nichts an den rekonstruierten BidCoS-Telegrammen oder
am bestätigten Link-B-Timing, sollte aber bei einer endgültigen HY-Hardware
untersucht werden.

---

## 32.6 Globaler Link-B-Zeitfaktor und Phasenverhalten

Die finale HY-Hardware benötigt keine große Korrektur ihrer lokalen MCU-Uhr.
Trotzdem zeigte sich, dass ein exakt nach der Idealformel laufender Link-B-
Zeitplan bei einzelnen VDs langfristig ungünstig relativ zu deren
Empfangsfenster liegen kann.

Der aktuell validierte HY-Ansatz ist:

```text
T_linkB = T_formel × 1.000030
```

also eine globale Verlängerung um:

```text
+30 ppm
```

Der Faktor gilt **für alle logischen HYs gleich**.

Da die 20 logischen Link-B-Zeitachsen unabhängig sind, darf die zur
Millisekundenrundung verwendete Bruchteil-/Restakkumulation pro Link-B-Zeitachse
separat geführt werden. Das ist keine individuelle Kalibrierung; der ppm-Faktor
bleibt für alle identisch.

Ein fester Phasenoffset von `+100 ms` brachte bei HY6 keine Verbesserung.
Die proportionale Intervallskalierung dagegen erhöhte die ACK-Quote deutlich.

Nach einem echten HY-Neustart ist die bisherige Link-B-Phase zunächst verloren.
Das muss nicht durch HY-spezifische Persistenz kompensiert werden: Die
automatische Resynchronisation des originalen HM-CC-VD wurde mit fünf
absichtlich unsynchronisierten VDs praktisch bestätigt.

---

# 33. Quellen

## S1 – BidCoS Reverse-Engineering

FKIE CAD – `bidcos-security-doc`

https://github.com/fkie-cad/bidcos-security-doc/blob/main/doc/1-bidcos.md

Relevant für:

- allgemeine BidCoS-Frame-Struktur
- Message Counter
- Control-Flags
- WakeMeUp
- Repeat Enable
- Message Types
- `0x02 RESPONSE`
- `0x01 RESPONSE_ACK_STATUS`
- `0x58 CLIMATE_EVENT`
- zyklische Empfangsstrategie

## S2 – FHEM HomeMatic Implementierung

`10_CUL_HM.pm`

https://raw.githubusercontent.com/mhop/fhem-mirror/master/fhem/FHEM/10_CUL_HM.pm

Relevant für:

- HM-CC-TC `0x58`-Dekodierung
- `adjust_command`
- Sollwert `/2.56`
- VD-Position `/2`
- VD-Statusbits
- Fehlercodes
- virtuelle TC-Implementierung
- Timingformel
- Message Counter
- Miss-Erkennung
- Persistieren von Counter und nächstem Termin
- `cyclicMsgOffset`

## S3 – HM-CC-TC Handbuch

HomeMatic HM-CC-TC Montage-/Bedienungsanleitung

Beispiel:

https://manualzz.com/doc/de/33500174/und-bedienungsanleitung-funk-wandthermostat-hm-cc-tc

Relevant für:

- TC ist Einzelraumregler
- autarke Regelung
- Ventilsteuerung
- Zykluszeit 120...184 s

## S4 – HM-CC-VD Handbuch

HomeMatic HM-CC-VD Installation and Operating Manual

https://manualzz.com/doc/64336738/homematic-hm-cc-vd-installation-and-operating-manual

Relevant für:

- VD nicht dauerhaft auf Empfang
- Synchronisationsverhalten
- einmal pro Stunde Resync
- max. 184 s Dauerempfang
- Störungsposition
- Fehleranzeigen
- Verhalten nach Batteriewechsel

## S5 – reale HMLAN/FHEM-Mitschnitte

Beispiele:

https://forum.fhem.de/index.php?topic=16926.0

https://forum.fhem.de/index.php?topic=17232.0

https://forum.fhem.de/index.php?topic=17232.15

Relevant für:

- reale `A2 58`-Frames
- reale `82 02`-Antworten
- `COMMAND=02`
- `COMMAND=03`
- Motorstatus
- zeitliche Abfolge
- `0x70` vor `0x58`
- mehrere VDs / Counterverhalten

## S6 – lokale Messungen und Emulationsvalidierung, September–November 2026

Verwendet wurden:

- CCU2-`multimac` als passiver BidCoS-Mitschnitt,
- serielle HY-Protokollierung,
- direkte Oszilloskopmessungen am CC1101-`GDO0` eines realen TC/VD-Paares,
- gezielte VD-Emulation gegenüber einem realen HM-CC-TC.

Damit lokal validiert:

- `0x70` ungefähr 20 s vor `0x58` mit identischem Counter,
- aktueller Counter bestimmt das Folgeintervall,
- Fortlauf des regulären TC-Zyklus trotz fehlendem ACK,
- kein unmittelbarer `A2 58`-Retry im beobachteten Miss-Fall,
- reale Antwortlage ungefähr 90...95 ms nach Ende des `A2 58`,
- Akzeptanz von `CTRL=0x82`,
- direkte Übernahme von `ACK_STATUS.POSITION` in die TC-Ventilstellungsanzeige,
- Positionen 0 %, 15 % und 75 % über `POSITION_RAW / 2`,
- praktische Link-B-Zeitabstände ohne zusätzlichen festen `+200-ms`-Offset,
- finale HY-Zeitbasis gegenüber unabhängigen CCU-Zeitstempeln nur wenige ppm abweichend; keine `9966/10000`-Korrektur auf der finalen externen 8-MHz-Quarz-Hardware,
- originale TC-Intervalle typischerweise geringfügig länger als die Idealformel (`ca. +13...+32 ppm`),
- HY6-Link-B mit globalem Zeitfaktor `+30 ppm`: Verbesserung von ca. `55,3 %` auf `97,96 %` ACK-Erfolg,
- globaler `+30-ppm`-Test mit zehn synchronisierten VDs: `223/224 = 99,55 %` ACK-Erfolg,
- automatische Resynchronisation von fünf absichtlich nicht manuell synchronisierten VDs nach HY-Neustart nach ungefähr `71...75,5 Minuten`,
- vom originalen VD gesendete ACK_STATUS-Frames, die bei schmaler RX-Bandbreite vom HY teilweise nicht dekodiert wurden,
- stabile Link-B-Kommunikation mit `MDMCFG4=0x88` / ca. 203,1 kHz RX-Bandbreite,
- unterschiedliche bzw. schwankende `FREQEST`-Werte, weshalb keine feste FSCTRL0-Korrektur übernommen wurde,
- praktische VD-Resynchronisation nach HY-Neustart durch kurzen Tastendruck,
- globaler Counter und Round-Robin bei zwei VDs (`172987`: `C8→10FC23`, `C9→13A146`, `CA→10FC23`, `CB→13A146`),
- globaler Counter und Round-Robin bei drei VDs (`187A60`: `D8→1379E3`, `D9→20368F`, `DA→193A01`, anschließend `DB/DC/DD` in derselben Reihenfolge).

Diese lokalen Messungen ergänzen die externen Quellen; wo sie nur Verhalten der HY-Emulation statt eines originalen VD belegen, ist dies im Text ausdrücklich gekennzeichnet.

---

# 34. Kurzreferenz

## TC → VD

```text
0B CNT A2 58 TC_ID VD_ID CMD TARGET
```

```text
TARGET[%] ≈ TARGET_RAW / 2.56
```

## VD → TC

```text
0E CNT 82 02 VD_ID TC_ID 01 01 POS STATUS RSSI
```

```text
POS[%] = POS_RAW / 2
```

## Status

```text
STATUS & 0x30:
00 stop
10 opening
20 closing
30 unknown
```

```text
ERROR = (STATUS >> 1) & 0x07

0 ok
1 blocked
2 loose / mount problem
3 adjusting range too small
4 battery critical
```

```text
STATUS & 0x80 → battery low
```

## Timing

```c
result =
    (((tcAddress << 8) | counter)
     * 1103515245 + 12345) >> 16;

interval =
    (result & 0xff) / 4.0 + 120.0;
```

```text
120.00 ... 183.75 s
```

Abstand `counter=n` zu `counter=n+1`:

```text
T(TC-ID,n)
```

Beobachtetes originales ACK-Timing:

```text
Ende TC A2 58 -> Beginn VD 82 02: ca. 90...95 ms
```

Gateway-/CCU-RX-Zeitstempel können dabei ungefähr `130 ms` auseinanderliegen,
weil sie zusätzlich die Sendedauer des ersten Telegramms enthalten.

Typische TC-Vorsequenz:

```text
CNT=n  86 70  -> ca. 20 s -> CNT=n  A2 58
```

## Counter

```text
00 ... FF → modulo 256
```

Request und zugehöriges ACK:

```text
gleicher Counter
```

## HY-Implementierungswerte (nicht Teil des Protokolls)

```text
finale HY-Hardware-Zeitbasis:       keine 9966/10000-Korrektur
globaler Link-B-Zeitfaktor:         +30 ppm  (= 1.000030)
individuelle ppm-Werte pro HY:       nein
zusätzlicher fester Link-B-Offset:   0 ms
VD-ACK-Empfangsfenster im HY:        300 ms
CC1101 MDMCFG4:                      0x88
RX-Bandbreite:                       ca. 203,1 kHz
FSCTRL0:                             unverändert
```

`+30 ppm` ist ein aktuell empirisch validierter HY-Implementierungswert und
keine veröffentlichte BidCoS-Protokollkonstante.
