sruetzler/HB-SR-Devices-AddOn/devices/HB-SR-HY/ccu/www/config/img/devices/250/hb-sr-hy.png

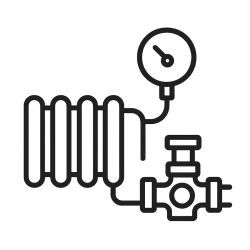
devices/HB-SR-HY/ccu/www/config/img/devices/250/hb-sr-hy.png
