sruetzler/HB-SR-Devices-AddOn/devices/HB-SR-HY/Hardware/HY_Streifenraster_Rev16_Bestueckung.png

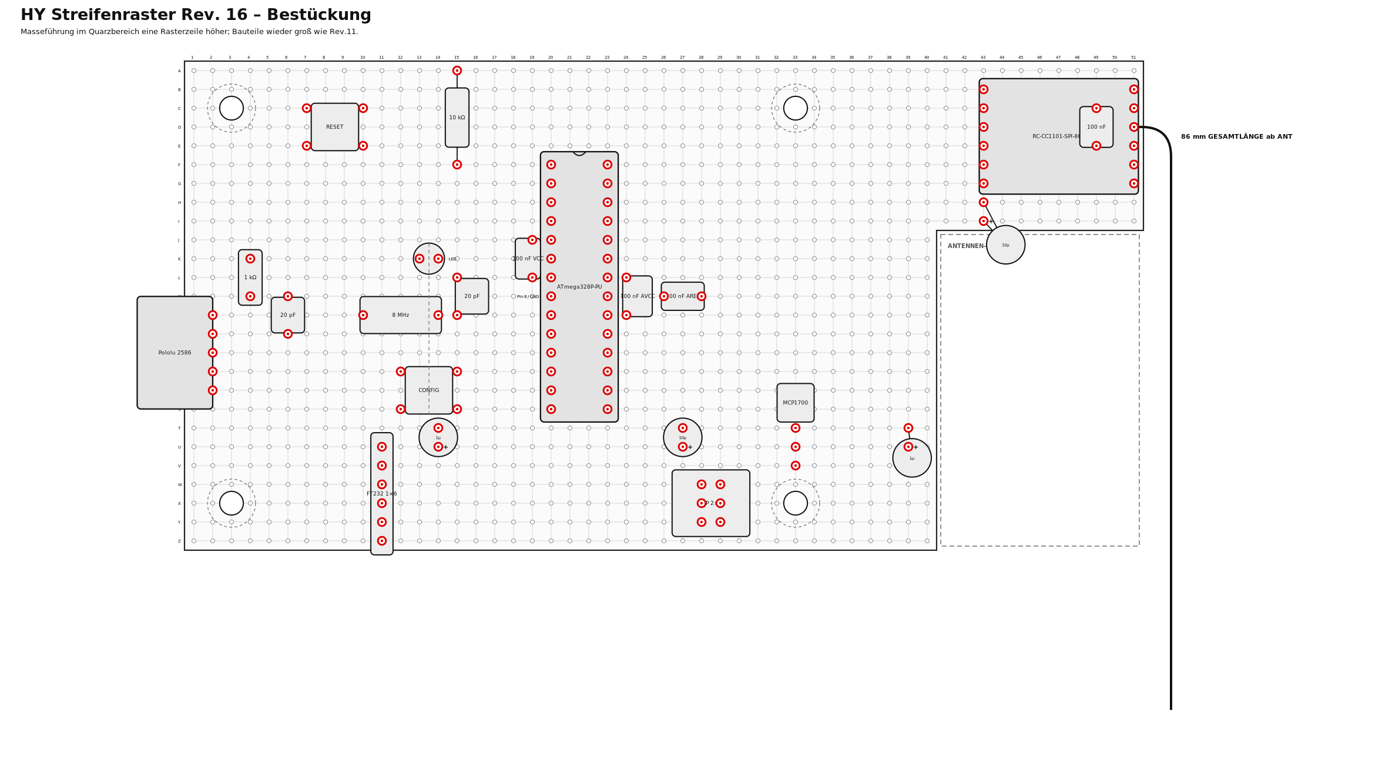
devices/HB-SR-HY/Hardware/HY_Streifenraster_Rev16_Bestueckung.png
