sruetzler/HB-SR-Devices-AddOn/devices/HB-SR-HY/Hardware/HY_Streifenraster_Rev16_Drahtbruecken.png

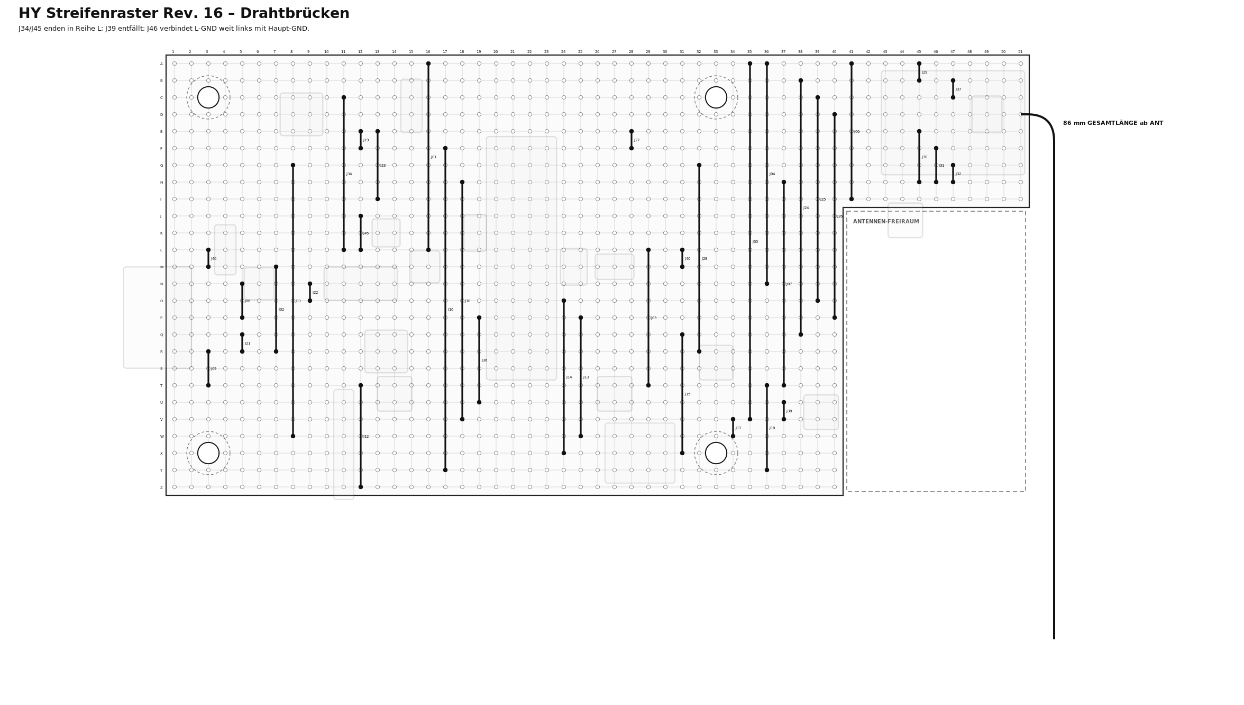
devices/HB-SR-HY/Hardware/HY_Streifenraster_Rev16_Drahtbruecken.png
