sruetzler/HB-SR-Devices-AddOn/devices/HB-SR-HY/Hardware/HY_Streifenraster_Rev17_Kupferschnitte_Loetseite.png

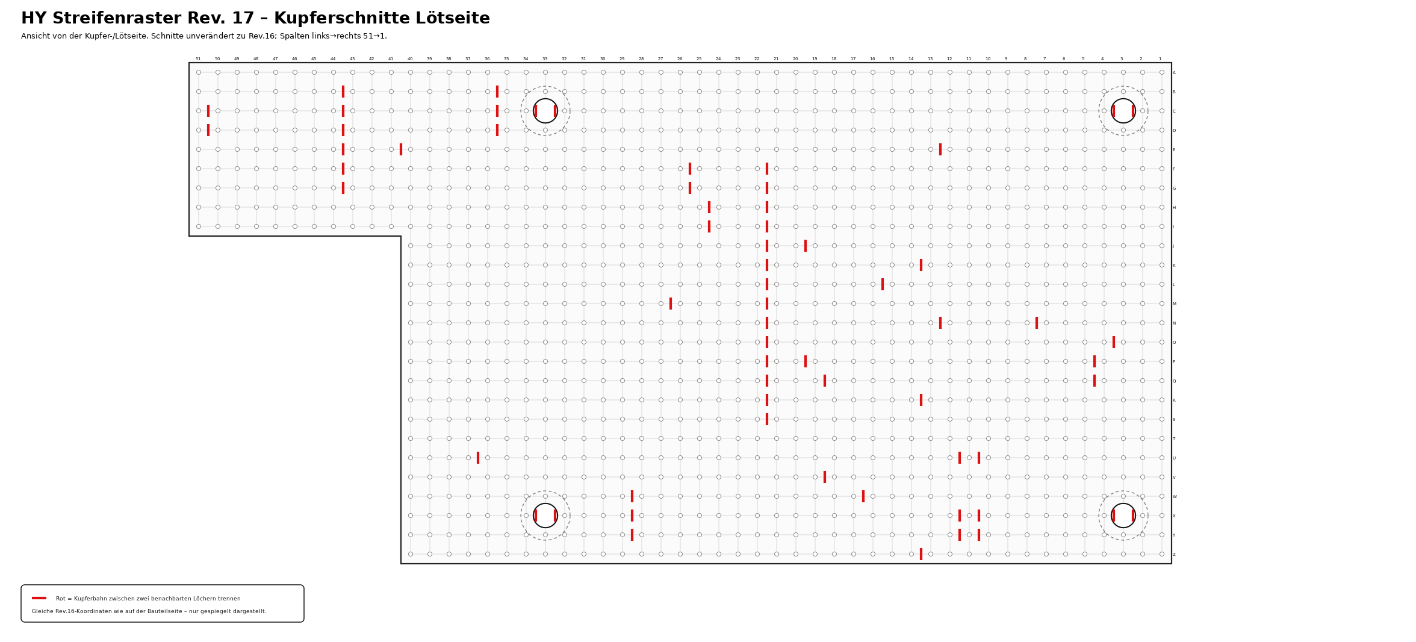
devices/HB-SR-HY/Hardware/HY_Streifenraster_Rev17_Kupferschnitte_Loetseite.png
