sruetzler/HB-SR-Devices-AddOn/docs/history/addon-README.md

# HB-SR-Devices-AddOn

This addon is based on https://github.com/TomMajor/SmartHome/tree/master/HB-TM-Devices-AddOn from Tom Major

## Unterstützte Geräte

- [HB-SR-HY]()

[comment]: # (rc.d filename: hb-sr-devices-addon, github name: HB-SR-Devices-AddOn, info name: HB-SR-Devices AddOn)

###### Die verwendeten Device Model IDs:

| Sensor | Device Model |
|---|---|
| HB-SR-HY | 0xF103 |

## Change Log

- 0.01 - 08.10.2025
  - Init

## Lizenz

<br />This work is licensed under a <a rel="license" href="http://creativecommons.org/licenses/by-nc-sa/4.0/">Creative Commons Attribution-NonCommercial-ShareAlike 4.0 International License</a>.
