sruetzler/HB-SR-Devices-AddOn/(commit log)

2026-02-26 thermostat schickt ventilstellung allerding bisher nur ans device
2026-03-05 get and return valve state
2026-03-14 forward message. But ack is still wrong
    [HB-SR-HY.ino]
2026-09-17 fix some issues, configuration set is working
    [HB-SR-HY.ino]
2026-09-21 2 device working
2026-09-25 teaching 20 devices working
2026-09-27 radio test with 20 device working
2026-09-29 fix radio init and stabilize CC1101 communication
    [HB-SR-HY.ino]
2026-10-05 fix error with unpaired TC
    [HB-SR-HY.ino]
2026-10-26 add isp programmer and atmega fuses
